Leanb2/Robot-Resolvedor-Cubo-Rubik-3x3/Impresiones 3D/rack.FCStd

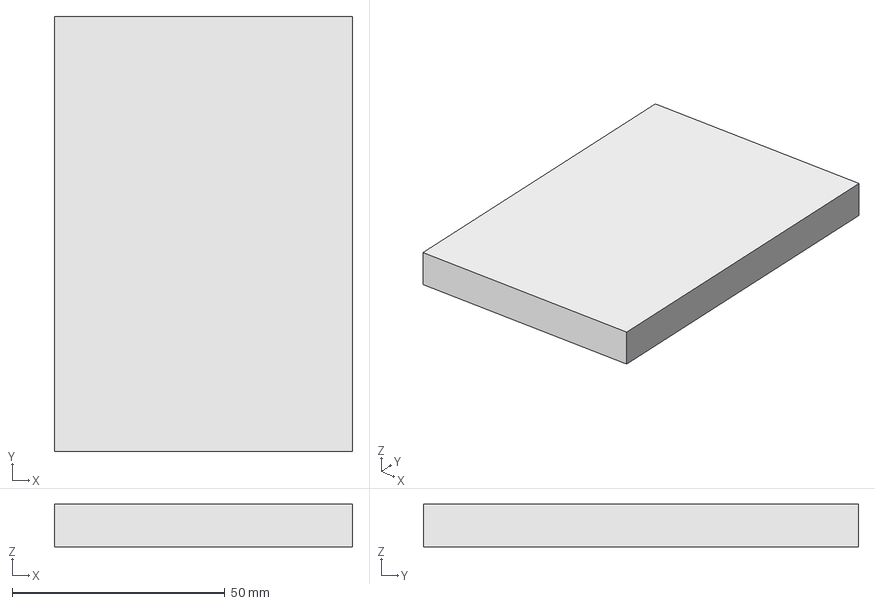
[picture p3: CAD file, 2023-11-10]
Impresiones 3D/rack.FCStd
70.0 x 102.2 x 10.0 mm
