Leanb2/Robot-Resolvedor-Cubo-Rubik-3x3/Impresiones 3D/servo-base.FCStd

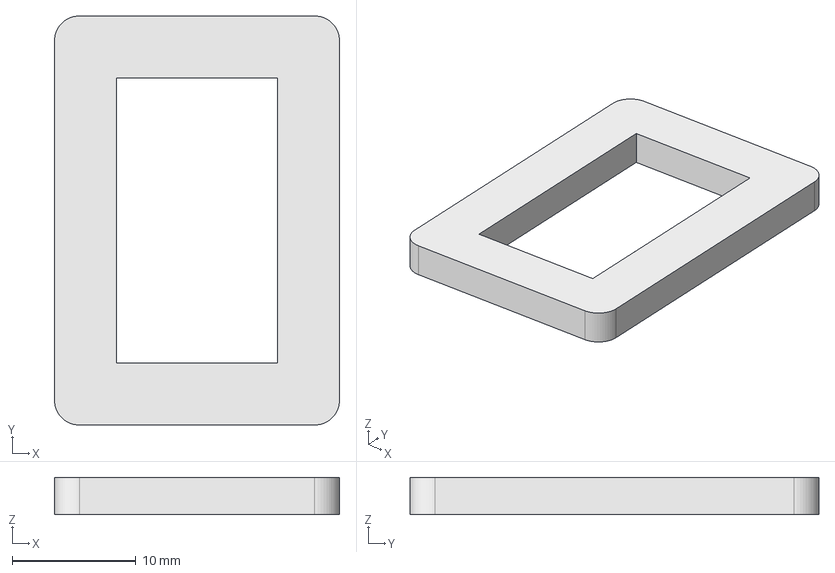
[picture p4: CAD file, 2023-11-10]
Impresiones 3D/servo-base.FCStd
23.0 x 33.0 x 3.00 mm
