Leanb2/Robot-Resolvedor-Cubo-Rubik-3x3/Impresiones 3D/gear.FCStd

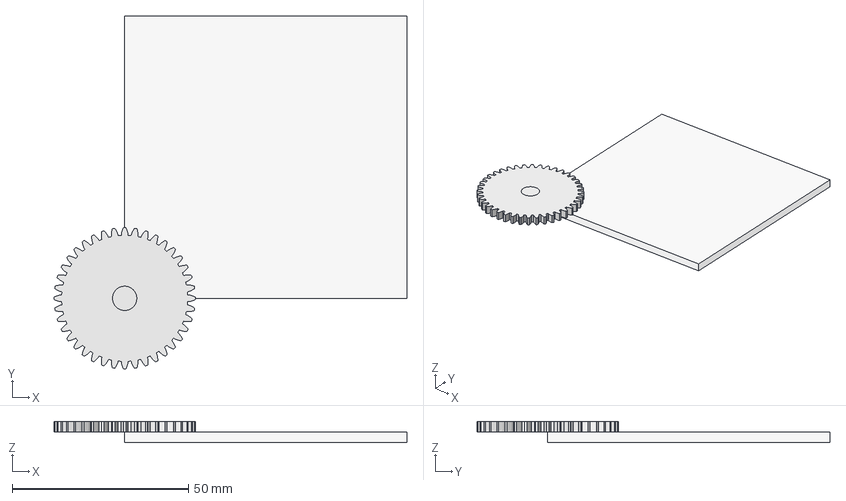
[picture p5: CAD file, 2023-11-10]
Impresiones 3D/gear.FCStd
100.2 x 100.2 x 6.00 mm
InvoluteGear
Gear
Stock
