Leanb2/Robot-Resolvedor-Cubo-Rubik-3x3/Impresiones 3D/turret.FCStd

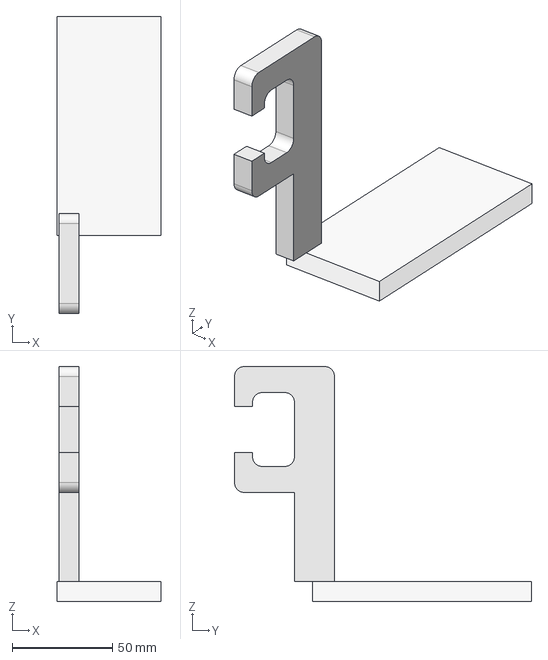
[picture p6: CAD file, 2023-11-10]
Impresiones 3D/turret.FCStd
52.0 x 148.5 x 117.5 mm
Stock
