Leanb2/Robot-Resolvedor-Cubo-Rubik-3x3/Impresiones 3D/base-bottom.FCStd

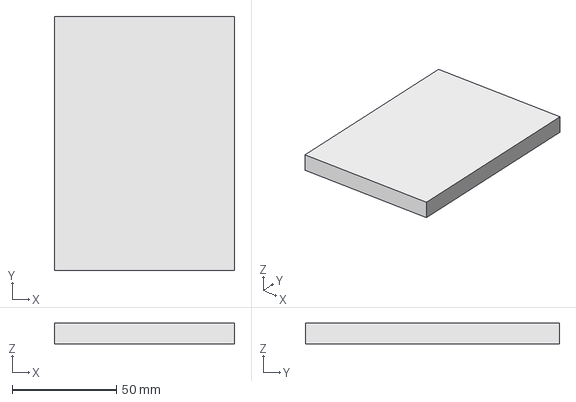
[picture p7: CAD file, 2023-11-10]
Impresiones 3D/base-bottom.FCStd
86.7 x 122.0 x 10.0 mm
