Leanb2/Robot-Resolvedor-Cubo-Rubik-3x3/Impresiones 3D/claw.FCStd

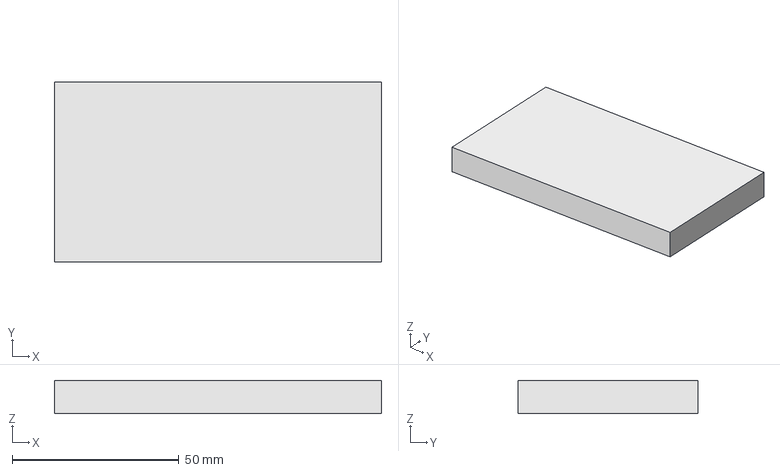
[picture p8: CAD file, 2023-11-10]
Impresiones 3D/claw.FCStd
98.0 x 54.0 x 10.0 mm
