Leanb2/Robot-Resolvedor-Cubo-Rubik-3x3/(list of files, cad)

Other CAD files:
Impresiones 3D/base-top.FCStd
